moonbomee/habitchi/팀원공유_기획변경_v2.md

# 해빗치 기획 변경 v2 (교수님 피드백 반영, 최종본 기준)

> 11/2 제안서 발표 피드백을 반영해서 기획을 다시 정리했어. PPT 최종본은 `habitchi/마녀와야수들_수정본_v2.key`이고, 이 문서와 내용이 같아. (이전 판 `마녀와야수들_수정본.key`는 착석·자세가 들어 있던 버전이야)

## 1. 교수님 피드백
**제안서 발표 피드백 (11/2)**
- **책상형으로 갈 거면** 버튼을 누르거나 태그를 대는 방식 말고, **실제로 측정하는 데이터**를 늘려라.
- **아니면 들고 다닐 수 있게** 만들어라.
- **기능을 좀 줄이더라도** 둘 중 하나를 골라라.

**추가로 하신 말씀**
- 센서를 원래 용도 그대로 쓰지 말고 **창의적으로 활용**해라. 예를 들어 스마트 휴지통이 찼는지를 거리센서 대신 팬과 공기압으로 알아낸 사례가 있었어.
- **시연이 가능하게**(특히 온습도 센서) 데모 시나리오를 잘 짜라.
- 이 PPT를 최종으로 제출하고, 그 뒤에는 **구현한 만큼 + 구현 난이도**로 평가하신대. 적힌 걸 못 하면 감점일 수 있으니까 확실한 것만 "필수"로 적었어.

## 2. 우리 결정: 책상형 유지 + 실제 측정 강화
**휴대형을 고르지 않은 이유**
- 휴대형으로 가려면 보드(Mega는 너무 큼), 배터리, 케이스를 다 바꿔야 해서 거의 처음부터 다시 해야 해.
- 들고 다니면서 잴 수 있는 건 걸음 수 정도야. 가방에 넣으면 조도센서로 수면을 판단할 수도 없어.

**블루투스로 책상형 + 휴대형을 합치지 않은 이유**
- 기기 두 대, 코드 두 벌, 배터리 충전, 블루투스 연결까지 해야 해서 3명이 4주 안에 하기엔 너무 위험해.
- 교수님이 "하나를 고르라"고 하신 것과도 반대 방향이야.

**그래서 원칙은 하나야.** 사용자가 "했다"고 입력하는 기능은 빼고, **센서나 PC가 직접 재는 데이터만** 펫의 상태에 반영해.

### 아두이노와 PC 역할 나누기
> 다른 조가 "아두이노가 하는 일이 없다"는 피드백을 받았어. 우리도 PC 기능이 많아서 같은 질문을 받을 수 있으니까 미리 정해 두자.

- **판단은 전부 아두이노가 해.** PC는 "몇 시에 커밋했는지, 메시지가 성의 있는지, 테스트가 통과했는지, 지금 키보드를 치는지" 같은 **사실만** 보내. 그게 야식인지, 밤샘인지, 펫이 아픈지는 아두이노가 RTC 시각과 센서 값, 펫 상태를 보고 정해.
- **PC가 꺼져 있어도 펫은 살아 있어.** 수면 환경(소등·소음·온도)과 폰 거치대는 아두이노 센서만으로 판단해.
- 교수님이 "PC 프로그램으로 하면 되지 않냐"고 물으시면 이렇게 답하자.
  > "PC는 방의 밝기, 새벽 3시의 소음, 방 온도를 알 수 없고, 잘 때는 꺼져 있습니다. 해빗치는 PC가 꺼진 밤에도 혼자 수면 환경을 잽니다."

## 3. 새 주제 설명
### 해빗치 (Habitchi) — 생활습관을 함께 돌보는 피지컬 다마고치
> 부제는 그대로 두기로 했어. 내용은 **컴공생의 수면 환경과 코딩 습관을 실제로 재는 책상 위 펫**이야.
> **"내가 건강해야 펫도 건강하다."**
> **콘셉트: 오래 앉아 있는 만큼, 그 시간을 책임져 주는 책상 위 다마고치.** 성인은 하루 평균 9시간을 앉아서 보내(2장 통계). 착석 시간을 직접 재지는 않지만, 그렇게 오래 머무는 책상 앞에서 수면·코딩 습관을 함께 챙겨 준다는 뜻이야.

- **수면 환경:** 실제로 불을 끈 시각과 켠 시각(수면 시간), 밤사이 소음, 방 온도를 재.
- **코딩 습관:** 어두운 데서 코딩하는지, 쉬지 않고 너무 오래 코딩하는지, 밤샘하는지, 폰을 내려놓고 집중하는지를 재.
- **컴공 도우미:** PC와 연결하면 **펫의 밥이 바로 내 커밋**이야. 테스트가 깨진 커밋은 상한 음식이야.

**바뀐 점 정리**
| | 이전 기획 | 새 기획 |
|---|---|---|
| 판단 근거 | 운동 타이머, BMI, 영양제 버튼, 음식 카드처럼 **입력 위주** | 조도, 소음, 온도, 압력, 키보드 사용, 커밋처럼 **측정 위주** |
| 책상형인 이유 | 약했음 | 잠자는 **방**과 코딩하는 **책상**의 환경을 재는 기기라서 책상에 있어야 함 |
| 컴공다움 | PC 연동은 부가 기능 | PC가 **컴공 도우미**로 핵심. 밥도 커밋 |
| 아두이노 역할 | — | 측정과 **모든 판단**은 아두이노가 해 |
| 센서 활용 | 센서를 원래 용도대로 | 확장 기능에서 센서를 원래 용도와 다르게 씀 (파란 LED → 빛 센서, 호일 → 물 높이 센서, 피에조 → 진동 센서) |

## 4. 기능표 (PPT 6장, 4줄)
**구분**
- **필수:** 반드시 완성해. PPT에 약속한 기능이야.
- **확장:** 필수를 다 만든 다음에 해. 못 해도 약속을 어긴 건 아니야. 표에서는 "(확장)"이라고 붙인 부분이야.

| 습관 | 실제로 재는 것 | 펫의 반응 | 구분 |
|---|---|---|---|
| **수면 환경** | 소등·기상 시각(조도 + RTC) → 실제 수면 시간, 밤사이 소음(사운드 센서), 방 온도(LM35)<br>(확장) 불 끈 뒤 화면 불빛 — 파란 LED를 빛 센서로 | 제때 바른 수면 환경이 갖추어지면 펫이 잠들고 회복, 기상 알람, 시끄러우면 잠을 설침, 추운 방에서 자면 **감기**<br>(확장) 자기 전에 화면을 보면 잠을 설침 | 필수·확장 |
| **코딩 습관** | PC 코딩 감지 + 방 밝기(조도), **연속 코딩 시간**(PC 키보드), 취침 후 커밋·키보드(PC)<br>(확장) 폰 거치대(압력 + 피에조 진동), 물병 수위(호일 정전용량) | 어두우면 눈 아파함, **50분 넘으면 "스트레칭하자!"**, 밤샘하면 졸려하고 경험치가 적게 쌓임<br>(확장) 알림 없이 폰을 들면 경험치가 적게 쌓임, 코딩 중 물을 안 마시면 목말라함 | 필수·확장 |
| **식사 = 커밋** | 커밋 메시지 분류(PC) + 커밋 시각·간격(아두이노)<br>(확장) 커밋 후 테스트·빌드 결과(PC) | 제대로 쓴 커밋은 건강식, 성의 없는 커밋은 정크푸드, 취침 후 커밋은 야식<br>(확장) 빌드가 깨진 커밋은 **배탈**(아파하는 소리·모션, 경험치 조금) | 필수·확장 |
| 운동 | 운동 전후 심박(심박센서) | 실제로 심박이 오르면 체력 상승 | 확장 |

### 세부 규칙
- **연속 코딩:** PC 키보드 입력이 이어진 시간을 재. 50분이 넘으면 "스트레칭하자!" 알림. **키보드가 5분 이상 멈추면 쉰 것으로 보고** 시간을 0으로 돌려. 알림을 무시하고 계속 코딩하면 체력이 깎여.
- **폰 거치대 (확장):** 압력센서(FSR)로 폰이 올려져 있는지, 키트 피에조(하나 더)로 알림 진동을 재. 알림 진동이 온 뒤 **5분 안에는** 폰을 들어도 괜찮아. 알림 없이 들면 경험치가 적게 쌓여.
- **수분 충전 (확장):** 물병 홀더 벽에 호일 두 장을 붙이고 CapacitiveSensor 라이브러리로 재. 연속 코딩하는 동안 한 번도 안 마시면 펫이 목말라해. 라이브러리의 **자동 보정은 꼭 꺼야 해**(`set_CS_AutocaL_Millis(0xFFFFFFFF)`).
- **화면 불빛 (확장):** 파란 LED에 반대 방향 전압을 걸었다가 놓고, 방전 시간을 재서 빛 센서로 써. PPT에는 "불 끈 뒤 화면 불빛 감지"까지만 적었어. 흰색 LED 조명에도 파란빛이 들어 있어서 조명과 화면을 색으로 구분한다고는 약속하지 않았어.
- **안 되면:** 화면 불빛은 조도센서로 대신해. 수분 충전은 빼. (PPT에는 대체안을 안 적었고, 우리끼리 정한 거야)

### 커밋 밥 규칙
| 커밋 종류 | 판단 기준 | 판단하는 곳 | 펫에게 |
|---|---|---|---|
| **건강식** | 메시지를 제대로 쓴 커밋 | PC (글자 분석만) | 포만감 +, 경험치 + |
| **정크푸드** | "fix", "asdf", "ㅁㄴㅇㄹ" 같은 성의 없는 메시지 | PC (글자 분석만) | 배는 부르지만 많이 먹으면 비만 |
| **야식** | 취침 시각 이후 커밋 | **아두이노** (RTC 시각 + 취침 시각) | 소화불량, 수면 점수 감소, 경험치 적게 |
| **과식** | 짧은 시간에 커밋을 너무 많이 올림 | **아두이노** (직전 커밋과의 간격 + 지금 포만감) | "배불러…", 효과 감소 |
| **상한 음식** (확장) | 테스트·빌드가 깨진 커밋 | PC가 git 훅으로 테스트를 돌려서 결과만 보냄 | **배탈**: 아파하는 소리·모션, 경험치 조금. 포만감은 오름 |

- PC는 `EVT,COMMIT,GOOD`, `EVT,COMMIT,JUNK`, `EVT,COMMIT,BROKEN`, `EVT,TYPING`처럼 **사실만** 보내.
- **굶는 것 방지:** 포만감은 천천히 줄고, 시험 기간 같은 쉬는 날 설정을 둬. PC가 오래 연결되지 않으면 배고픔이 줄어드는 걸 멈춰.

## 5. 펫 (PPT 7장)
### 상태 수치
| 수치 | 회복·상승 | 감소 |
|---|---|---|
| 포만감 | 커밋(밥) | 시간이 지나면 천천히 |
| 수면 | 제때 자고, 조용하고 따뜻하면 회복 | 늦게 자기, 밤샘, 소음 |
| 체력 | 잘 자고 운동하면 회복 | **밤샘·감기·쉬지 않는 코딩** |
| **경험치** | 커밋할수록 상승 | 밤샘 커밋, 배탈, 알림 없이 폰 들기 → 적게 쌓임 |

### 성장과 진화
- 알 → 아기 → 성장기 → **건강형**(수면·코딩 습관·커밋 고르게) / **허약형**(수면 부족·감기) / **비만형**(정크·야식 커밋 과다)

### 아픔과 죽음
- **아픔이 되는 원인 4가지**
  - **감기:** 추운 방에서 자는 날이 이어짐
  - **수면 부족:** 수면이 0인 상태가 계속됨
  - **굶주림:** 포만감이 0인 상태가 계속됨
  - **과로:** 체력이 0인 상태가 계속됨
- 배탈, 소화불량, 졸림, 눈 아픔, 목마름은 **잠깐 나오는 반응**이고 아픔은 아니야.
- **아픈 채로 1일**(시연 모드에서는 약 24분)이 지나도록 회복하지 않으면 **죽어.** 전원이 꺼져 있거나 쉬는 날에는 시간이 멈춰.
- 죽으면 묘비 화면을 보여 주고 **알로 다시 시작**해. "3대째 해빗치"처럼 **세대 수와 이전 펫이 살았던 날수**를 EEPROM에 남겨.
- 테스트할 때 펫이 죽지 않도록 **죽음을 끄는 개발용 설정**을 하나 두자.

### 기타
| 기능 | 내용 | 부품 | 구분 |
|---|---|---|---|
| 표정·애니메이션 | 기분과 성장 단계별 표정 | OLED | 필수 |
| 소리 | 효과음, 기상 알람, 경고음 | 피에조 (키트) | 필수 |
| 저장 | 전원이 꺼져도 펫 상태 유지 | EEPROM (보드 내장) | 필수 |
| 시연 모드 | 시각을 버튼으로 직접 설정(예: 22:59 → 바로 취침 장면) + 1분 = 1시간 | 버튼 (키트) | PPT에는 없지만 시연하려면 꼭 필요 |

### 뺀 기능
| 기능 | 뺀 이유 |
|---|---|
| **착석·자세, 화면 거리** | 등받이와 사람을 구분하기 어렵고 경우의 수가 너무 많음 → **연속 코딩 시간**으로 대체. 초음파 센서도 뺌. 배경의 좌식 9시간 통계는 "그 시간을 책임져 주는 펫"이라는 콘셉트의 근거로 남김 |
| **눈 피로(화면 쪽 조도)** | 조도센서를 너무 많이 써서 뺌 |
| 서보로 몸 흔들기 | 펫은 화면 속에 있어서 움직일 게 애매함 |
| RFID 음식 카드 | 태그를 대는 건 실제로 먹었다는 증거가 아님 → **커밋 = 밥**으로 대체 |
| 운동 타이머, BMI 입력, 영양제 버튼 | 사용자가 직접 입력하는 방식이라 피드백과 맞지 않음 |
| 날씨·미세먼지 | 아두이노가 하는 일이 없음 → 향후 발전 방향으로 옮김 |
| 환기(CO2) | 진짜 CO2 센서는 비싸고, 싼 센서는 CO2를 정확히 못 잼 → 넣지 않음 |

## 6. 부품 (PPT 10~11장)
### 센서·모듈
| 부품 | 용도 | 수량 | 금액(원) | 비고 |
|---|---|---|---|---|
| OLED 0.96" SSD1306 I2C [VLT-OL022] | 펫 표정 화면 | 1 | 7,040 | |
| DS3231 RTC 모듈 [SZH-EK047] | 취침·기상 시각 | 1 | 5,280 | |
| CR2032 코인전지 | RTC 백업 전원 | 1 | 990 | |
| 고감도 사운드 센서 [SEN050302] | 밤사이 소음 | 1 | 5,170 | 해외 배송, 준비 3~4일 |
| **FSR 압력 센서 모듈 [KS0309]** | 폰 거치대 (확장) | 1 | 9,020 | 핀이 달린 모듈이라 납땜 없음. **해외 배송 1주, 반품 불가** |
| 심박센서 키트 [SZH-HWS008] | 운동 검증 (확장) | 1 | 4,950 | |
| 파란 LED 5mm 투명 고휘도 [5BB4SC00] | 화면 불빛 (확장) | 2 | 440 | 1개는 여분 |
| 1/4W 저항 1MΩ [105J] | 물병 수위·피에조 (확장) | 20 | 506 | 최소 주문 20개 |

- 소계 33,396원
- **뺀 부품:** 초음파 센서 HC-SR04(−1,210원), CdS 조도센서 ×2(−396원)

### 배선·조립 (그대로)
점퍼 케이블 4종, U자 점퍼와이어 키트, PCB 서포트·나사·너트, 미니 브레드보드, 케이블타이, 케이스 BB161 — 22,880원

### 키트에 있어서 안 사는 것
- Arduino Mega, LM35, **피에조 2개**(하나는 소리, 하나는 폰 진동 감지), 버튼, 저항(10kΩ), 브레드보드, 조도센서 1개(방 밝기)

### 금액 (디바이스마트 한 번에 주문)
| | 금액 |
|---|---|
| 부품 | 56,276원 |
| 배송비 | 2,700원 |
| **총액** | **58,976원** |
| 1인당 (3명) | 약 19,700원 |

**받으면 확인할 것**
- 사운드 센서의 작은 나사(가변저항)를 돌려 보면서 `analogRead` 값이 소리에 따라 실제로 변하는지 확인해야 해.
- 압력센서에 폰을 올렸다 내렸다 하면서 값 차이가 분명한지 확인해야 해.
- 파란 LED, 호일, 피에조 진동 감지는 키트 부품으로도 먼저 시험해 볼 수 있어.

## 7. 역할 (제안)
- **A · 펫 본체:** OLED 표정, 상태 수치·성장·진화·아픔·죽음, 피에조 소리, 저장(EEPROM), 시연 모드
- **B · 센서:** 조도 + RTC 수면, 사운드 센서 소음, LM35 감기, (확장) 압력·피에조 폰 거치대, 파란 LED, 호일 물병, 심박
- **C · PC 컴공 도우미:** 파이썬 시리얼 통신, 커밋 메시지 분류, 키보드 사용 시간, (확장) git 훅 테스트 결과, 대시보드
  - 아두이노 쪽 규칙(야식·과식·밤샘·연속 코딩 판단)은 A와 C가 같이 만들기

**공통 규칙**
- `delay()` 금지.
- 기능은 각자 `update()` 함수 하나로 만들기.
- 선 색 통일: 빨강 5V, 검정 GND.

## 8. 다음 할 일
1. PPT 최종본(`마녀와야수들_수정본_v2.key`) 제출하기
2. 부품 주문 (다들 확인한 다음에). 압력센서는 반품이 안 되니까 주문 전에 한 번 더 확인
3. 각자 맡은 모듈부터 따로 동작시키기. 부품이 오기 전에는 키트에 있는 조도·LM35·LED·피에조로 먼저 연습하기
4. 시연 시나리오 짜기 (교수님이 특히 강조하심)
   - 시각은 버튼으로 직접 맞춰서 장면을 바로 보여 주기 (예: 22:59 → 취침, 06:59 → 기상 알람)
   - 방 온도는 발표장에서 바꿀 수 없으니까 **차가운 캔이나 손으로 LM35 온도를 바꿔서** 보여 주기

## 9. 개발 시작 (11/4)
코드는 `habitchi` 폴더에 다 들어 있어. **처음 보는 사람은 `docs/ARCHITECTURE.md` → `docs/wiring.md` 순서로 읽어 줘.**

| 폴더·문서 | 내용 |
|---|---|
| `firmware/habitchi/habitchi.ino` | 아두이노 본 코드 (Arduino IDE로 열기) |
| `firmware/tests/` | 부품 하나씩 시험하는 작은 스케치 9개 |
| `pc/` | PC 프로그램: 시리얼 브리지, 키보드 감지, 커밋 훅, 대시보드 |
| `docs/wiring.md` | **전체 배선과 조립 순서**, 꽂기 전 점검 목록 |
| `docs/sensors.md`, `clock_input.md`, `display_sound.md`, `pet.md`, `pc.md` | 담당별 자세한 설명 |

**역할 나누기 추천:** 코드가 아래처럼 나뉘어 있어서 서로 같은 파일을 고칠 일이 거의 없어.

| 담당 | 파일 |
|---|---|
| 센서 (`Sensor*.cpp`, `SensorsConfig.h`) + 배선 | 한 명 |
| 펫 판단 (`Pet*.cpp`, `PetConfig.h`) + 화면 그림(`Sprites.h`) | 한 명 |
| PC 프로그램 (`pc/`) + 시계·버튼 + 시연 준비 | 한 명 |

**규칙:**
- 코드에 주석은 쓰지 않고, 설명은 `docs/`에 써.
- `delay()`는 쓰지 마.
- 핀 번호는 `Pins.h`에서만 바꿔.

**개발하면서 정한 것:**
- 버튼:
  - A 길게 = 시연 모드, A 짧게 = 화면 전환
  - 시연 모드에서 B = +1시간, C = +10분
  - B 길게 = 운동 시작/끝, C 길게 = 폰 두기 모드
- 시연 모드:
  - 시간이 60배 빨라
  - 연속 코딩 30초면 스트레칭 알림, 10초 쉬면 휴식으로 봐
  - 폰은 알림 뒤 5초까지 봐줘
- 시연 단축 명령은 PC 브리지 터미널에 입력해: `stage child`, `sick cold`, `die`, `evolve`.
- 취침 23시 / 기상 7시. 알람은 불을 켜면 꺼져. 아예 안 잔 날은 수면 0점이야.
- 운동 결과는 "심박 +N"(올라간 정도)으로 나와. 측정에 실패하면 "다시 재 줘"가 나와.
- 폰 두기 모드는 전원을 껐다 켜도 기억해.
- 화면 글자는 한글이야. 다만 글꼴에 없는 글자는 안 보이니까 문구를 바꿀 때 `docs/display_sound.md`를 확인해.
- 캐릭터는 지금 임시 그림이야. 우리가 그린 그림으로 바꾸는 방법도 같은 문서에 있어.

**부품이 오면:** `docs/wiring.md`의 순서대로 한 부품씩 꽂고 시험 스케치로 확인한 다음, 찾은 기준값을 `SensorsConfig.h`에 적자. 지금 기준값은 전부 추정치야.
