moonbomee/habitchi/docs/images/screen_belly.png

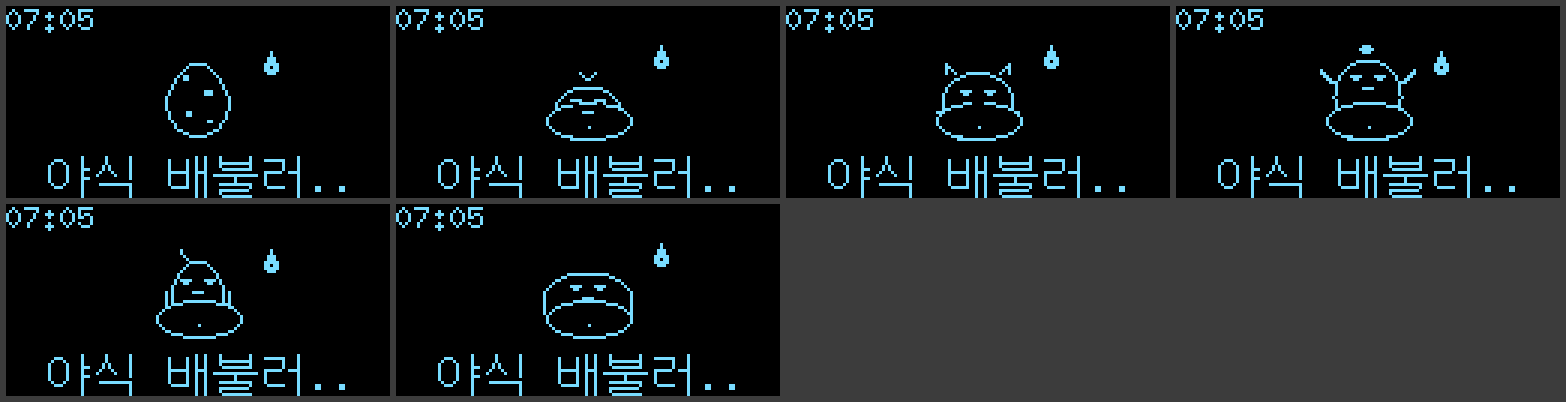
docs/images/screen_belly.png
