moonbomee/habitchi/docs/images/sprites.png

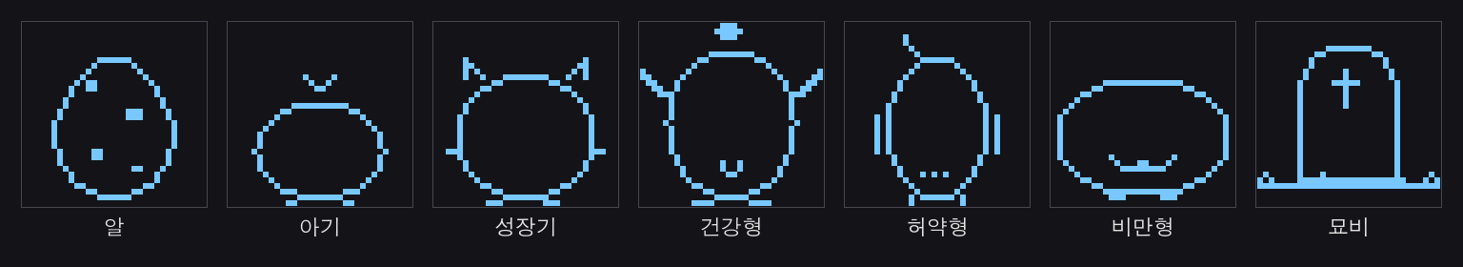
docs/images/sprites.png
