moonbomee/habitchi/firmware/habitchi/Sprites.h

#pragma once
#include <Arduino.h>

const uint8_t SPRITE_W = 32;
const uint8_t SPRITE_H = 32;

const uint8_t SPRITE_EGG[] PROGMEM = {
  0x00, 0x00, 0x00, 0x00, 0x00, 0x00, 0x00, 0x00, 0x00, 0x00, 0x00, 0x00, 0x00, 0x00, 0x00, 0x00,
  0x00, 0x00, 0x00, 0x00, 0x00, 0x00, 0x00, 0x00, 0x00, 0xe0, 0x07, 0x00, 0x00, 0x10, 0x08, 0x00,
  0x00, 0x08, 0x10, 0x00, 0x00, 0x04, 0x20, 0x00, 0x00, 0x1a, 0x40, 0x00, 0x00, 0x19, 0x80, 0x00,
  0x00, 0x01, 0x80, 0x00, 0x80, 0x00, 0x00, 0x01, 0x80, 0x00, 0x00, 0x01, 0x40, 0x00, 0x1c, 0x02,
  0x40, 0x00, 0x1c, 0x02, 0x20, 0x00, 0x00, 0x04, 0x20, 0x00, 0x00, 0x04, 0x20, 0x00, 0x00, 0x04,
  0x20, 0x00, 0x00, 0x04, 0x20, 0x00, 0x00, 0x04, 0x40, 0x30, 0x00, 0x02, 0x40, 0x30, 0x00, 0x02,
  0x40, 0x00, 0x00, 0x02, 0x80, 0x00, 0x18, 0x01, 0x00, 0x01, 0x80, 0x00, 0x00, 0x01, 0x80, 0x00,
  0x00, 0x06, 0x60, 0x00, 0x00, 0x18, 0x18, 0x00, 0x00, 0xe0, 0x07, 0x00, 0x00, 0x00, 0x00, 0x00
};

const uint8_t SPRITE_BABY[] PROGMEM = {
  0x00, 0x00, 0x00, 0x00, 0x00, 0x00, 0x00, 0x00, 0x00, 0x00, 0x00, 0x00, 0x00, 0x00, 0x00, 0x00,
  0x00, 0x00, 0x00, 0x00, 0x00, 0x00, 0x00, 0x00, 0x00, 0x00, 0x00, 0x00, 0x00, 0x00, 0x00, 0x00,
  0x00, 0x00, 0x00, 0x00, 0x00, 0x20, 0x04, 0x00, 0x00, 0x40, 0x02, 0x00, 0x00, 0x80, 0x01, 0x00,
  0x00, 0x00, 0x00, 0x00, 0x00, 0x00, 0x00, 0x00, 0x00, 0xf8, 0x1f, 0x00, 0x00, 0x06, 0x60, 0x00,
  0x00, 0x01, 0x80, 0x00, 0x80, 0x00, 0x00, 0x01, 0x40, 0x00, 0x00, 0x02, 0x20, 0x00, 0x00, 0x04,
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
const uint8_t ICON_PHONE_W = 6;
const uint8_t ICON_H = 8;

const uint8_t ICON_PC[] PROGMEM = {
  0xff, 0x03, 0x01, 0x02, 0x01, 0x02, 0x01, 0x02, 0xff, 0x03, 0x30, 0x00, 0xfc, 0x00, 0x00, 0x00
};

const uint8_t ICON_PHONE[] PROGMEM = {
  0x3f, 0x21, 0x21, 0x21, 0x21, 0x3f, 0x33, 0x3f
};
