moonbomee/habitchi/firmware/habitchi/SpritesDoguri.h

#pragma once
#include <Arduino.h>

const uint8_t DOGURI_FACE_Y_BABY = 15;
const uint8_t SPRITE_DOGURI_BABY[] PROGMEM = {
  0x00, 0x00, 0x00, 0x00, 0x00, 0x00, 0x00, 0x00, 0x00, 0x00, 0x00, 0x00, 0x00, 0x00, 0x00, 0x00,
  0x00, 0x00, 0x00, 0x00, 0x00, 0x00, 0x00, 0x00, 0x00, 0x0f, 0xf0, 0x00, 0x80, 0x19, 0x98, 0x01,
  0xc0, 0xf0, 0x0f, 0x01, 0xc0, 0x1c, 0x38, 0x01, 0xc0, 0x81, 0x81, 0x01, 0xe0, 0x80, 0x00, 0x03,
  0x60, 0x9c, 0x38, 0x02, 0x10, 0xff, 0xff, 0x04, 0x10, 0xff, 0xff, 0x04, 0xd8, 0x00, 0x00, 0x0d,
  0xc8, 0x00, 0x00, 0x09, 0xe8, 0x00, 0x00, 0x0b, 0xe8, 0x00, 0x00, 0x0b, 0xe8, 0x00, 0x00, 0x0b,
  0xf8, 0x00, 0x00, 0x0f, 0xd0, 0x00, 0x00, 0x07, 0x10, 0x00, 0x00, 0x04, 0x20, 0xff, 0xff, 0x00,
  0xc0, 0xf8, 0x1f, 0x01, 0x00, 0x03, 0xc0, 0x06, 0x00, 0x1c, 0xf8, 0x19, 0x00, 0x36, 0x4c, 0x13,
  0x00, 0x22, 0x44, 0x0e, 0x00, 0xe4, 0xcf, 0x07, 0x00, 0x1c, 0x38, 0x00, 0x00, 0x00, 0x00, 0x00
};

const uint8_t DOGURI_FACE_Y_CHILD = 12;
const uint8_t SPRITE_DOGURI_CHILD[] PROGMEM = {
  0x00, 0x00, 0x00, 0x00, 0x00, 0x00, 0x00, 0x00, 0x00, 0x00, 0x00, 0x00, 0x00, 0x0f, 0xf0, 0x00,
  0xc0, 0x19, 0x98, 0x01, 0xc0, 0xf0, 0x0f, 0x01, 0xc0, 0x1e, 0x78, 0x01, 0xe0, 0x81, 0x81, 0x03,
  0x60, 0x80, 0x00, 0x02, 0x70, 0x1c, 0x38, 0x06, 0xb0, 0xff, 0xff, 0x04, 0x98, 0xff, 0xff, 0x09,
  0xd8, 0x00, 0x00, 0x0b, 0xc4, 0x00, 0x00, 0x13, 0xe4, 0x00, 0x00, 0x17, 0xe4, 0x00, 0x00, 0x17,
  0xe4, 0x00, 0x00, 0x17, 0xf8, 0x00, 0x00, 0x1f, 0xf8, 0x00, 0x00, 0x0b, 0x90, 0x00, 0x00, 0x05,
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
  0x00, 0xff, 0xff, 0x30, 0xe0, 0x00, 0x00, 0xef, 0x38, 0x00, 0x00, 0xd8, 0x74, 0x00, 0x00, 0xa4,
  0x3a, 0x00, 0x00, 0x4e, 0x1a, 0x00, 0x00, 0xb8, 0x19, 0x00, 0x00, 0xb0, 0x19, 0x00, 0x00, 0xbc,
  0x39, 0x00, 0x00, 0x84, 0x22, 0x00, 0x00, 0x40, 0xfc, 0x01, 0x80, 0x3f, 0xf0, 0xff, 0xff, 0x0f
};
