moonbomee/habitchi/firmware/habitchi/SpritesSaero.h

#pragma once
#include <Arduino.h>

const uint8_t SPRITE_SAERO_BABY[] PROGMEM = {
  0x00, 0x00, 0x00, 0x00, 0x00, 0x00, 0x00, 0x00, 0x00, 0x00, 0x00, 0x00, 0x00, 0x00, 0x00, 0x00,
  0x00, 0x00, 0x00, 0x00, 0x00, 0x00, 0x00, 0x00, 0x00, 0x00, 0x00, 0x00, 0x00, 0x00, 0x00, 0x00,
  0x00, 0x00, 0x00, 0x00, 0x00, 0x00, 0x00, 0x00, 0x00, 0x00, 0x00, 0x00, 0x00, 0x06, 0x60, 0x00,
  0x00, 0x0d, 0xb0, 0x00, 0x80, 0x10, 0x08, 0x01, 0x80, 0x30, 0x0c, 0x01, 0x80, 0x20, 0x04, 0x01,
  0x40, 0xe0, 0x07, 0x02, 0x40, 0x00, 0x00, 0x02, 0x40, 0x00, 0x00, 0x02, 0x80, 0x00, 0x00, 0x01,
  0x80, 0x00, 0x00, 0x01, 0x00, 0x01, 0x80, 0x90, 0x00, 0x01, 0x80, 0xd8, 0x00, 0x02, 0x40, 0x7c,
  0x00, 0x02, 0x40, 0x64, 0x00, 0x92, 0x49, 0x20, 0x00, 0x93, 0xc9, 0x30, 0x00, 0x6c, 0x36, 0x1e,
  0x00, 0x00, 0x00, 0x00, 0x00, 0x00, 0x00, 0x00, 0x00, 0x00, 0x00, 0x00, 0x00, 0x00, 0x00, 0x00
};

const uint8_t SPRITE_SAERO_CHILD[] PROGMEM = {
  0x00, 0x00, 0x00, 0x00, 0x00, 0x00, 0x00, 0x00, 0x00, 0x00, 0x00, 0x00, 0x00, 0x00, 0x00, 0x00,
  0x00, 0x00, 0x00, 0x00, 0x00, 0x00, 0x00, 0x00, 0x00, 0x06, 0x60, 0x00, 0x00, 0x0d, 0xb0, 0x00,
  0x80, 0x10, 0x08, 0x01, 0x80, 0x30, 0x0c, 0x01, 0x80, 0x20, 0x04, 0x01, 0x40, 0xe0, 0x07, 0x02,
  0x40, 0x00, 0x00, 0x02, 0x40, 0x00, 0x00, 0x02, 0x40, 0x00, 0x00, 0x02, 0x40, 0x00, 0x00, 0x02,
  0x40, 0x00, 0x00, 0x02, 0x40, 0x00, 0x00, 0x02, 0x40, 0x00, 0x00, 0x02, 0x40, 0x00, 0x00, 0x02,
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
  0x08, 0x00, 0x00, 0x10, 0x08, 0x00, 0x00, 0x10, 0x10, 0x00, 0x00, 0x08, 0x14, 0x00, 0x00, 0x28,
  0x2d, 0x00, 0x00, 0xb4, 0x3f, 0x00, 0x00, 0xfc, 0x33, 0x09, 0x90, 0xcc, 0x32, 0x09, 0x90, 0x4c,
  0xc6, 0xf6, 0x6f, 0x63, 0x3c, 0x00, 0x00, 0x3c, 0x00, 0x00, 0x00, 0x00, 0x00, 0x00, 0x00, 0x00
};
