moonbomee/habitchi/firmware/habitchi/SpritesWonsaki.h

#pragma once
#include <Arduino.h>

const uint8_t SPRITE_WONSAKI_BABY[] PROGMEM = {
  0x00, 0x00, 0x00, 0x00, 0x00, 0x00, 0x00, 0x00, 0x00, 0x00, 0x00, 0x00, 0x00, 0x00, 0x00, 0x00,
  0x00, 0x00, 0x00, 0x00, 0x00, 0x00, 0x00, 0x00, 0x00, 0x07, 0xe0, 0x00, 0x80, 0x08, 0x10, 0x01,
  0x80, 0x1b, 0xd8, 0x01, 0x80, 0x12, 0x48, 0x01, 0x80, 0x12, 0x48, 0x01, 0x80, 0xf2, 0x4f, 0x01,
  0x80, 0x0a, 0x50, 0x01, 0x00, 0x00, 0x00, 0x03, 0x20, 0x00, 0x00, 0x06, 0x30, 0x00, 0x00, 0x04,
  0x10, 0x00, 0x00, 0x04, 0x10, 0x00, 0x00, 0x0c, 0x08, 0x00, 0x00, 0x08, 0x18, 0x00, 0x00, 0x08,
  0x10, 0x00, 0x00, 0x0c, 0x30, 0x00, 0x00, 0x06, 0xe0, 0x01, 0xc0, 0x03, 0x80, 0x00, 0x40, 0x02,
  0x80, 0x01, 0x00, 0x03, 0x00, 0x01, 0x80, 0x00, 0x00, 0x01, 0x80, 0x03, 0x00, 0xe7, 0xe7, 0x02,
  0x00, 0x34, 0x2c, 0x03, 0x00, 0x08, 0x10, 0x00, 0x00, 0x00, 0x00, 0x00, 0x00, 0x00, 0x00, 0x00
};

const uint8_t SPRITE_WONSAKI_CHILD[] PROGMEM = {
  0x00, 0x00, 0x00, 0x00, 0x00, 0x00, 0x00, 0x00, 0x00, 0x00, 0x00, 0x00, 0x00, 0x00, 0x00, 0x00,
  0x00, 0x0c, 0x70, 0x00, 0x00, 0x19, 0x88, 0x00, 0x00, 0x17, 0xb8, 0x00, 0x00, 0x15, 0xa8, 0x00,
  0x00, 0x55, 0xa8, 0x00, 0x00, 0x95, 0xa9, 0x00, 0x00, 0x95, 0xa8, 0x00, 0x00, 0xef, 0xb3, 0x00,
  0x00, 0x01, 0x00, 0x01, 0xc0, 0x00, 0x00, 0x03, 0x60, 0x00, 0x00, 0x06, 0x20, 0x00, 0x00, 0x04,
  0x20, 0x00, 0x00, 0x04, 0x20, 0x00, 0x00, 0x04, 0x20, 0x00, 0x00, 0x04, 0x60, 0x00, 0x00, 0x02,
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
  0x0c, 0x00, 0x00, 0x60, 0x70, 0x00, 0x00, 0x30, 0xc0, 0x03, 0x00, 0x0e, 0x80, 0x01, 0x00, 0x0e,
  0xc0, 0x12, 0x20, 0x09, 0x40, 0x12, 0x20, 0x11, 0x40, 0x16, 0xa0, 0x11, 0x40, 0x1c, 0xe0, 0x18,
  0xc0, 0x00, 0x00, 0x0c, 0x80, 0x03, 0x83, 0x03, 0x00, 0x3e, 0xc7, 0x00, 0x00, 0xe0, 0x3d, 0x00
};
