moonbomee/habitchi/firmware/habitchi/DisplayTexts.h

#pragma once
#include <Arduino.h>

const char TXT_GOOD_MORNING[] PROGMEM = "좋은 아침! ";
const char TXT_SCORE_UNIT[] PROGMEM = "점";
const char TXT_COLD_NIGHT[] PROGMEM = "밤에 추웠어";
const char TXT_NOISY_NIGHT[] PROGMEM = "밤에 시끄러웠어";
const char TXT_SCREEN_BEFORE_SLEEP[] PROGMEM = "자기 전 화면..";
const char TXT_STRETCH_NOW[] PROGMEM = "스트레칭하자!";
const char TXT_DRINK_WATER[] PROGMEM = "물 마시자!";
const char TXT_PHONE_DOWN[] PROGMEM = "폰 내려놓자";
const char TXT_HEART_RATE[] PROGMEM = "심박 ";
const char TXT_PLUS[] PROGMEM = "+";
const char TXT_MEASURE_AGAIN[] PROGMEM = "다시 재 줘";
const char TXT_NEW_GENERATION[] PROGMEM = "대째 해빗치";

const char TXT_MOOD_NORMAL[] PROGMEM = "괜찮아";
const char TXT_MOOD_HAPPY[] PROGMEM = "좋아!";
const char TXT_MOOD_HUNGRY[] PROGMEM = "배고파";
const char TXT_MOOD_SLEEPY[] PROGMEM = "자고 싶어";
const char TXT_MOOD_SLEEPING[] PROGMEM = "자는 중";
const char TXT_MOOD_SORE_EYES[] PROGMEM = "눈이 아파";
const char TXT_MOOD_STRETCH[] PROGMEM = "스트레칭!";
const char TXT_MOOD_STOMACHACHE[] PROGMEM = "배 아파..";
const char TXT_NIGHT_SNACK[] PROGMEM = "야식";
const char TXT_MOOD_INDIGESTION[] PROGMEM = "속이 아파";
const char TXT_MOOD_FULL[] PROGMEM = "배불러";
const char TXT_MOOD_THIRSTY[] PROGMEM = "목말라";
const char TXT_MOOD_COLD[] PROGMEM = "으, 추워";
const char TXT_MOOD_SICK[] PROGMEM = "몸이 아파";
const char TXT_MOOD_STUDYING[] PROGMEM = "공부 중";
const char TXT_MOOD_EXERCISING[] PROGMEM = "운동 중";
const char TXT_MOOD_DEAD[] PROGMEM = "안녕..";

const char TXT_STAGE_EGG[] PROGMEM = "알";
const char TXT_STAGE_BABY[] PROGMEM = "아기";
const char TXT_STAGE_CHILD[] PROGMEM = "성장기";
const char TXT_STAGE_HEALTHY[] PROGMEM = "건강형";
const char TXT_STAGE_WEAK[] PROGMEM = "허약형";
const char TXT_STAGE_OBESE[] PROGMEM = "비만형";
const char TXT_STAGE_DEAD[] PROGMEM = "하늘나라";

const char TXT_FULLNESS[] PROGMEM = "포만감";
const char TXT_REST[] PROGMEM = "수면";
const char TXT_STAMINA[] PROGMEM = "체력";
const char TXT_GENERATION_UNIT[] PROGMEM = "세대";

const char TXT_DEMO_BADGE[] PROGMEM = "DEMO";


const char TXT_WONSAKI[] PROGMEM = "원사기";
const char TXT_SAERO[] PROGMEM = "새로";
const char TXT_DOGURI[] PROGMEM = "도구리";
const char TXT_HATCHED[] PROGMEM = " 부화!";
const char TXT_EXP_SHORT[] PROGMEM = "EXP ";
