moonbomee/habitchi/firmware/habitchi/DisplayGlyphs.h

#pragma once
#include <Arduino.h>

const uint8_t EXTRA_GLYPH_COUNT = 11;

const uint16_t EXTRA_GLYPH_CODES[] PROGMEM = {
  0xD5C8, 0xD3EC, 0xCE6D, 0xBE57, 0xD3F0, 0xBC15, 0xC5D0, 0xC6E0, 0xB044, 0xC6CC, 0xC918
};

const uint8_t EXTRA_GLYPHS[][32] PROGMEM = {
  {0x00, 0x00, 0x00, 0x00, 0x00, 0x20, 0xf0, 0x20, 0x00, 0x20, 0xfc, 0x23, 0x00, 0x20, 0xf0, 0x3c, 0x08, 0x21, 0x08, 0x21, 0x08, 0x21, 0x08, 0x21, 0xf0, 0x20, 0x00, 0x20, 0x00, 0x20, 0x00, 0x20},
  {0x00, 0x00, 0x00, 0x00, 0x00, 0x00, 0xf8, 0x3f, 0x00, 0x00, 0x20, 0x08, 0x20, 0x08, 0x20, 0x08, 0x20, 0x08, 0xf8, 0x3f, 0x00, 0x01, 0x00, 0x01, 0x00, 0x01, 0xfe, 0xff, 0x00, 0x00, 0x00, 0x00},
  {0x00, 0x00, 0x00, 0x00, 0xf8, 0x20, 0x00, 0x20, 0xfc, 0x21, 0x20, 0x20, 0x50, 0x20, 0x88, 0x20, 0x04, 0x21, 0x00, 0x20, 0x00, 0x00, 0xf0, 0x1f, 0x08, 0x20, 0x08, 0x20, 0x08, 0x20, 0xf0, 0x1f},
  {0x00, 0x00, 0x00, 0x00, 0x04, 0x21, 0x04, 0x21, 0x04, 0x21, 0xfc, 0x21, 0x04, 0x21, 0x04, 0x21, 0xf8, 0x21, 0x00, 0x20, 0x00, 0x00, 0x00, 0x01, 0x00, 0x01, 0x80, 0x02, 0x60, 0x0c, 0x18, 0x30},
  {0x00, 0x00, 0x00, 0x00, 0xf8, 0x3f, 0x20, 0x08, 0x20, 0x08, 0x20, 0x08, 0xf8, 0x3f, 0x00, 0x01, 0x00, 0x01, 0xfe, 0xff, 0x00, 0x00, 0x08, 0x00, 0x08, 0x00, 0x08, 0x00, 0x08, 0x00, 0xf0, 0x3f},
  {0x00, 0x00, 0x00, 0x00, 0x04, 0x21, 0x04, 0x21, 0x04, 0x21, 0xfc, 0xe1, 0x04, 0x21, 0x04, 0x21, 0xf8, 0x21, 0x00, 0x20, 0x00, 0x00, 0xf8, 0x3f, 0x00, 0x20, 0x00, 0x20, 0x00, 0x20, 0x00, 0x20},
  {0x00, 0x00, 0x00, 0x00, 0x00, 0x48, 0x70, 0x48, 0x88, 0x48, 0x04, 0x49, 0x04, 0x49, 0x04, 0x4f, 0x04, 0x49, 0x04, 0x49, 0x04, 0x49, 0x88, 0x48, 0x70, 0x48, 0x00, 0x48, 0x00, 0x48, 0x00, 0x48},
  {0x00, 0x00, 0x00, 0x00, 0xf8, 0x20, 0x04, 0x21, 0x04, 0x21, 0x04, 0x39, 0xf8, 0x20, 0x00, 0x20, 0xfe, 0x2f, 0x20, 0x20, 0x20, 0x00, 0x20, 0x08, 0x20, 0x08, 0x20, 0x08, 0x50, 0x14, 0x8c, 0x63},
  {0x00, 0x00, 0x00, 0x00, 0x00, 0x00, 0xf8, 0x3e, 0x80, 0x20, 0x80, 0x20, 0x80, 0x20, 0x80, 0x20, 0x40, 0x20, 0x20, 0x20, 0x10, 0x10, 0x00, 0x00, 0x00, 0x00, 0xfe, 0xff, 0x00, 0x00, 0x00, 0x00},
  {0x00, 0x00, 0x00, 0x00, 0xf8, 0x20, 0x04, 0x21, 0x04, 0x21, 0x04, 0x21, 0xf8, 0x20, 0x00, 0x20, 0x00, 0x20, 0xfe, 0x2f, 0x20, 0x20, 0x20, 0x20, 0x20, 0x3c, 0x20, 0x20, 0x20, 0x20, 0x20, 0x20},
  {0x00, 0x00, 0x00, 0x00, 0xfc, 0x21, 0x20, 0x20, 0x50, 0x20, 0x88, 0x20, 0x04, 0x21, 0x00, 0x20, 0x00, 0x20, 0xfe, 0x2f, 0x20, 0x20, 0x20, 0x20, 0x20, 0x3c, 0x20, 0x20, 0x20, 0x20, 0x20, 0x20}
};
