moonbomee/habitchi/(commit log)

2026-11-04 해빗치 초안
2026-11-04 README 수정
2026-11-04 발표 파일 정리
2026-11-04 Update README.md
    Updated the description of the project to clarify the functionality and the role of Arduino in decision-making.
2026-11-04 화면 미리보기 이미지 추가
2026-11-04 캐릭터 3종과 랜덤 부화 추가
